davidMadueke/Simple-DAW-Transport-Controller/assets/Endless Encoder Mode Architecture v1.jpg

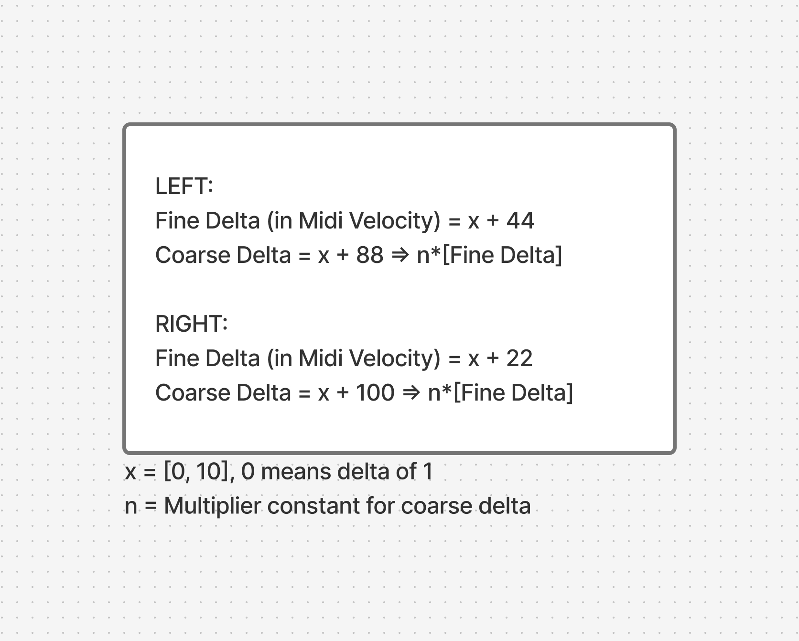
assets/Endless Encoder Mode Architecture v1.jpg
