davidMadueke/Simple-DAW-Transport-Controller/assets/Midi Protocol Architecture v1 13082026.jpg

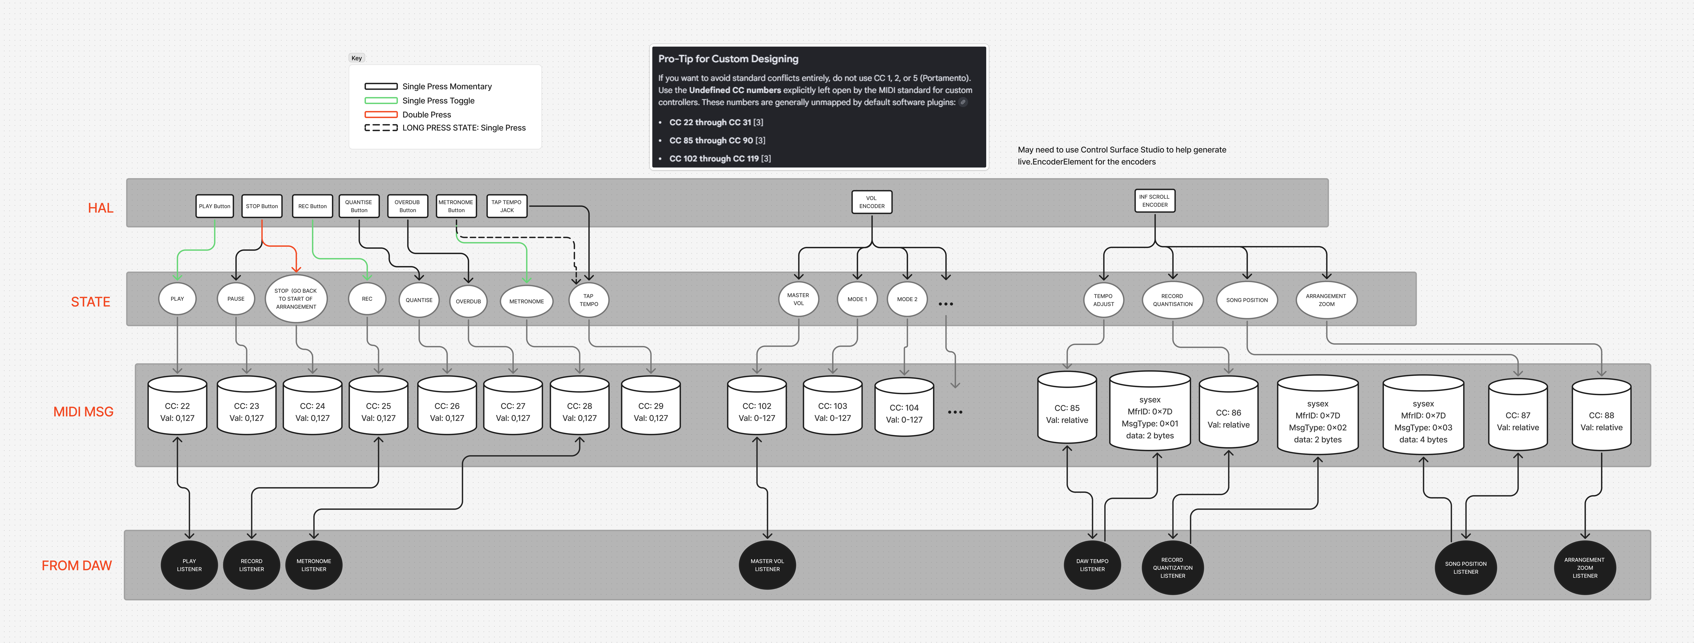
assets/Midi Protocol Architecture v1 13082026.jpg
