davidMadueke/Simple-DAW-Transport-Controller/assets/Midi Sysex Protocol Architecture v1.jpg

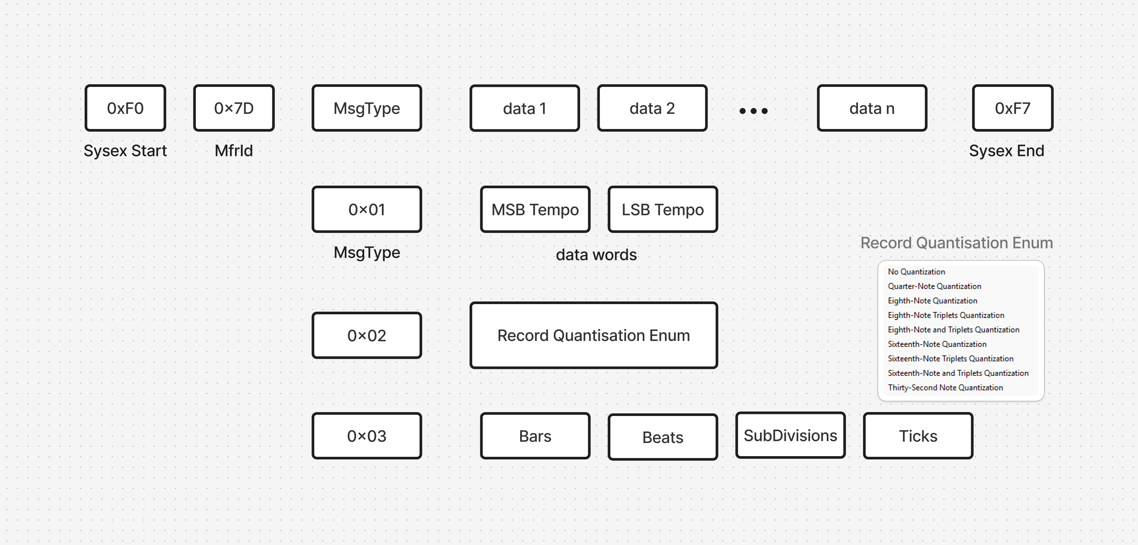
assets/Midi Sysex Protocol Architecture v1.jpg
