davidMadueke/Simple-DAW-Transport-Controller/assets/SW Architecture v7 13082026.png

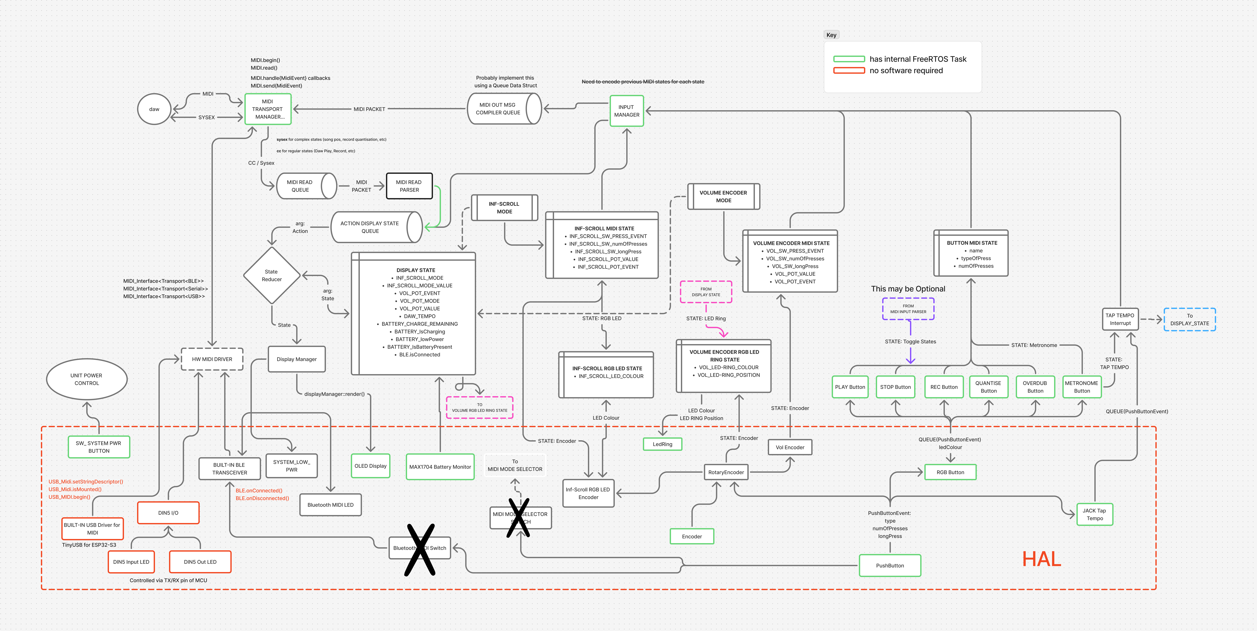
assets/SW Architecture v7 13082026.png
