davidMadueke/Simple-DAW-Transport-Controller/hardware/drawings/10032025_01_[HWE] Simple Transport Midi Controller.pdf

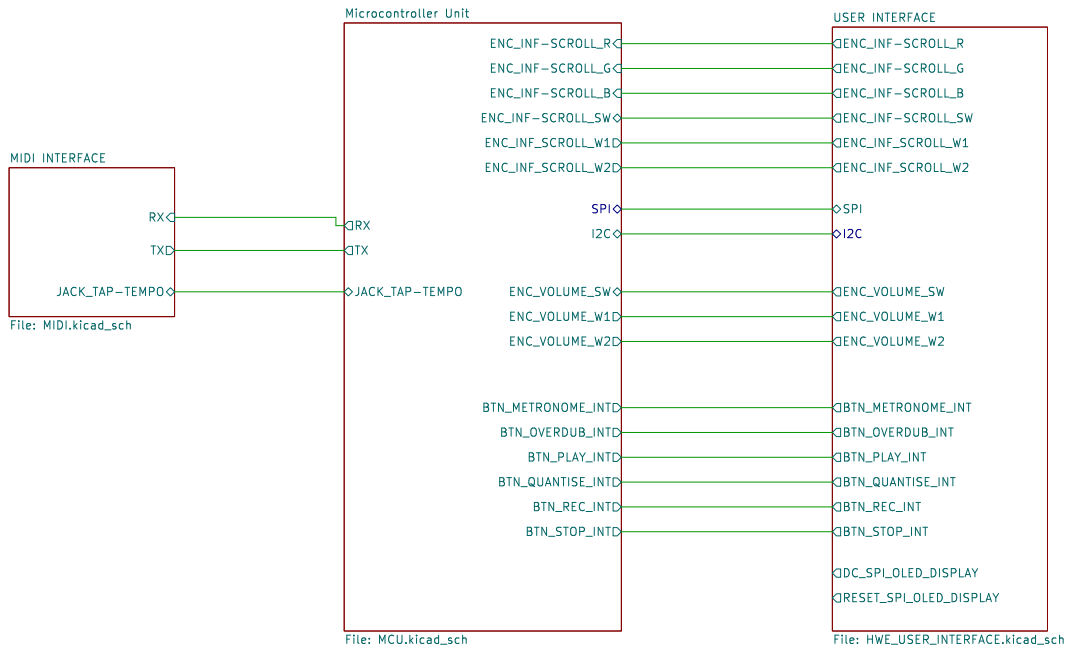
[picture p5: page 1]

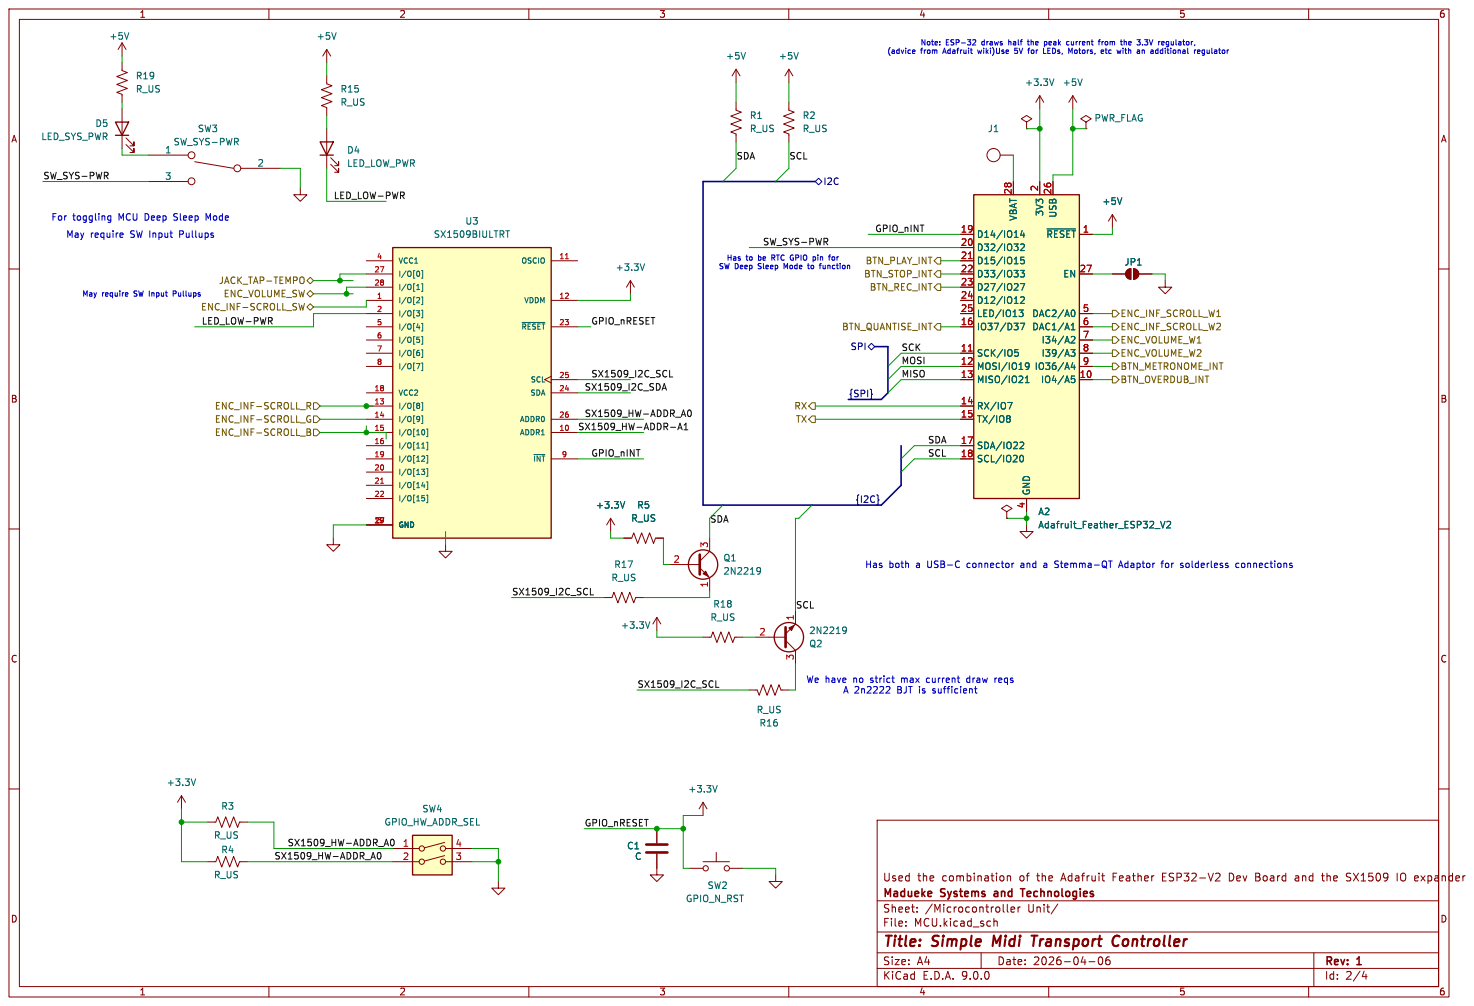
[picture p6: page 2]

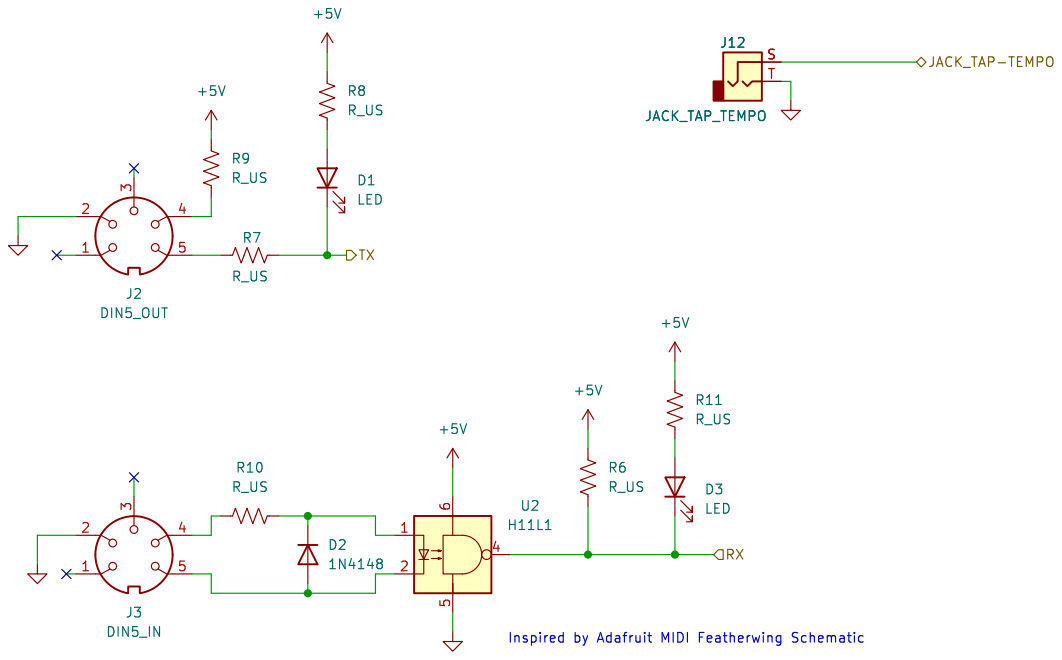
[picture p7: page 3]

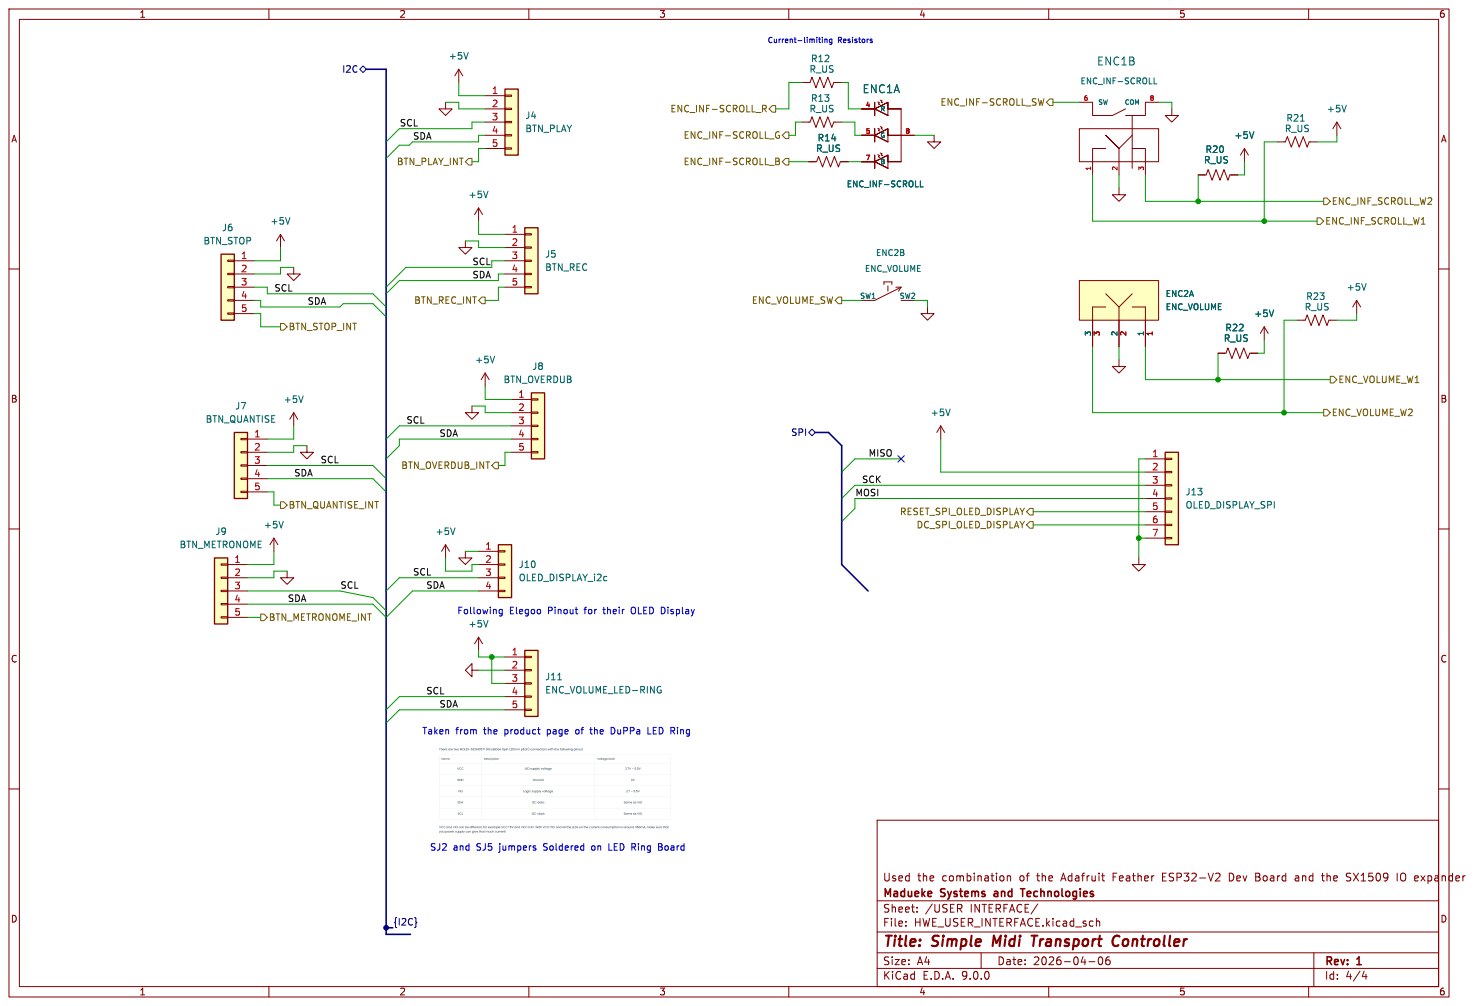
[picture p8: page 4]
