davidMadueke/Simple-DAW-Transport-Controller/hardware/10032025_01_[HWE] Simple Transport Midi Controller.kicad_pcb

## KiCad design hardware/calculator/calculator.kicad_sch

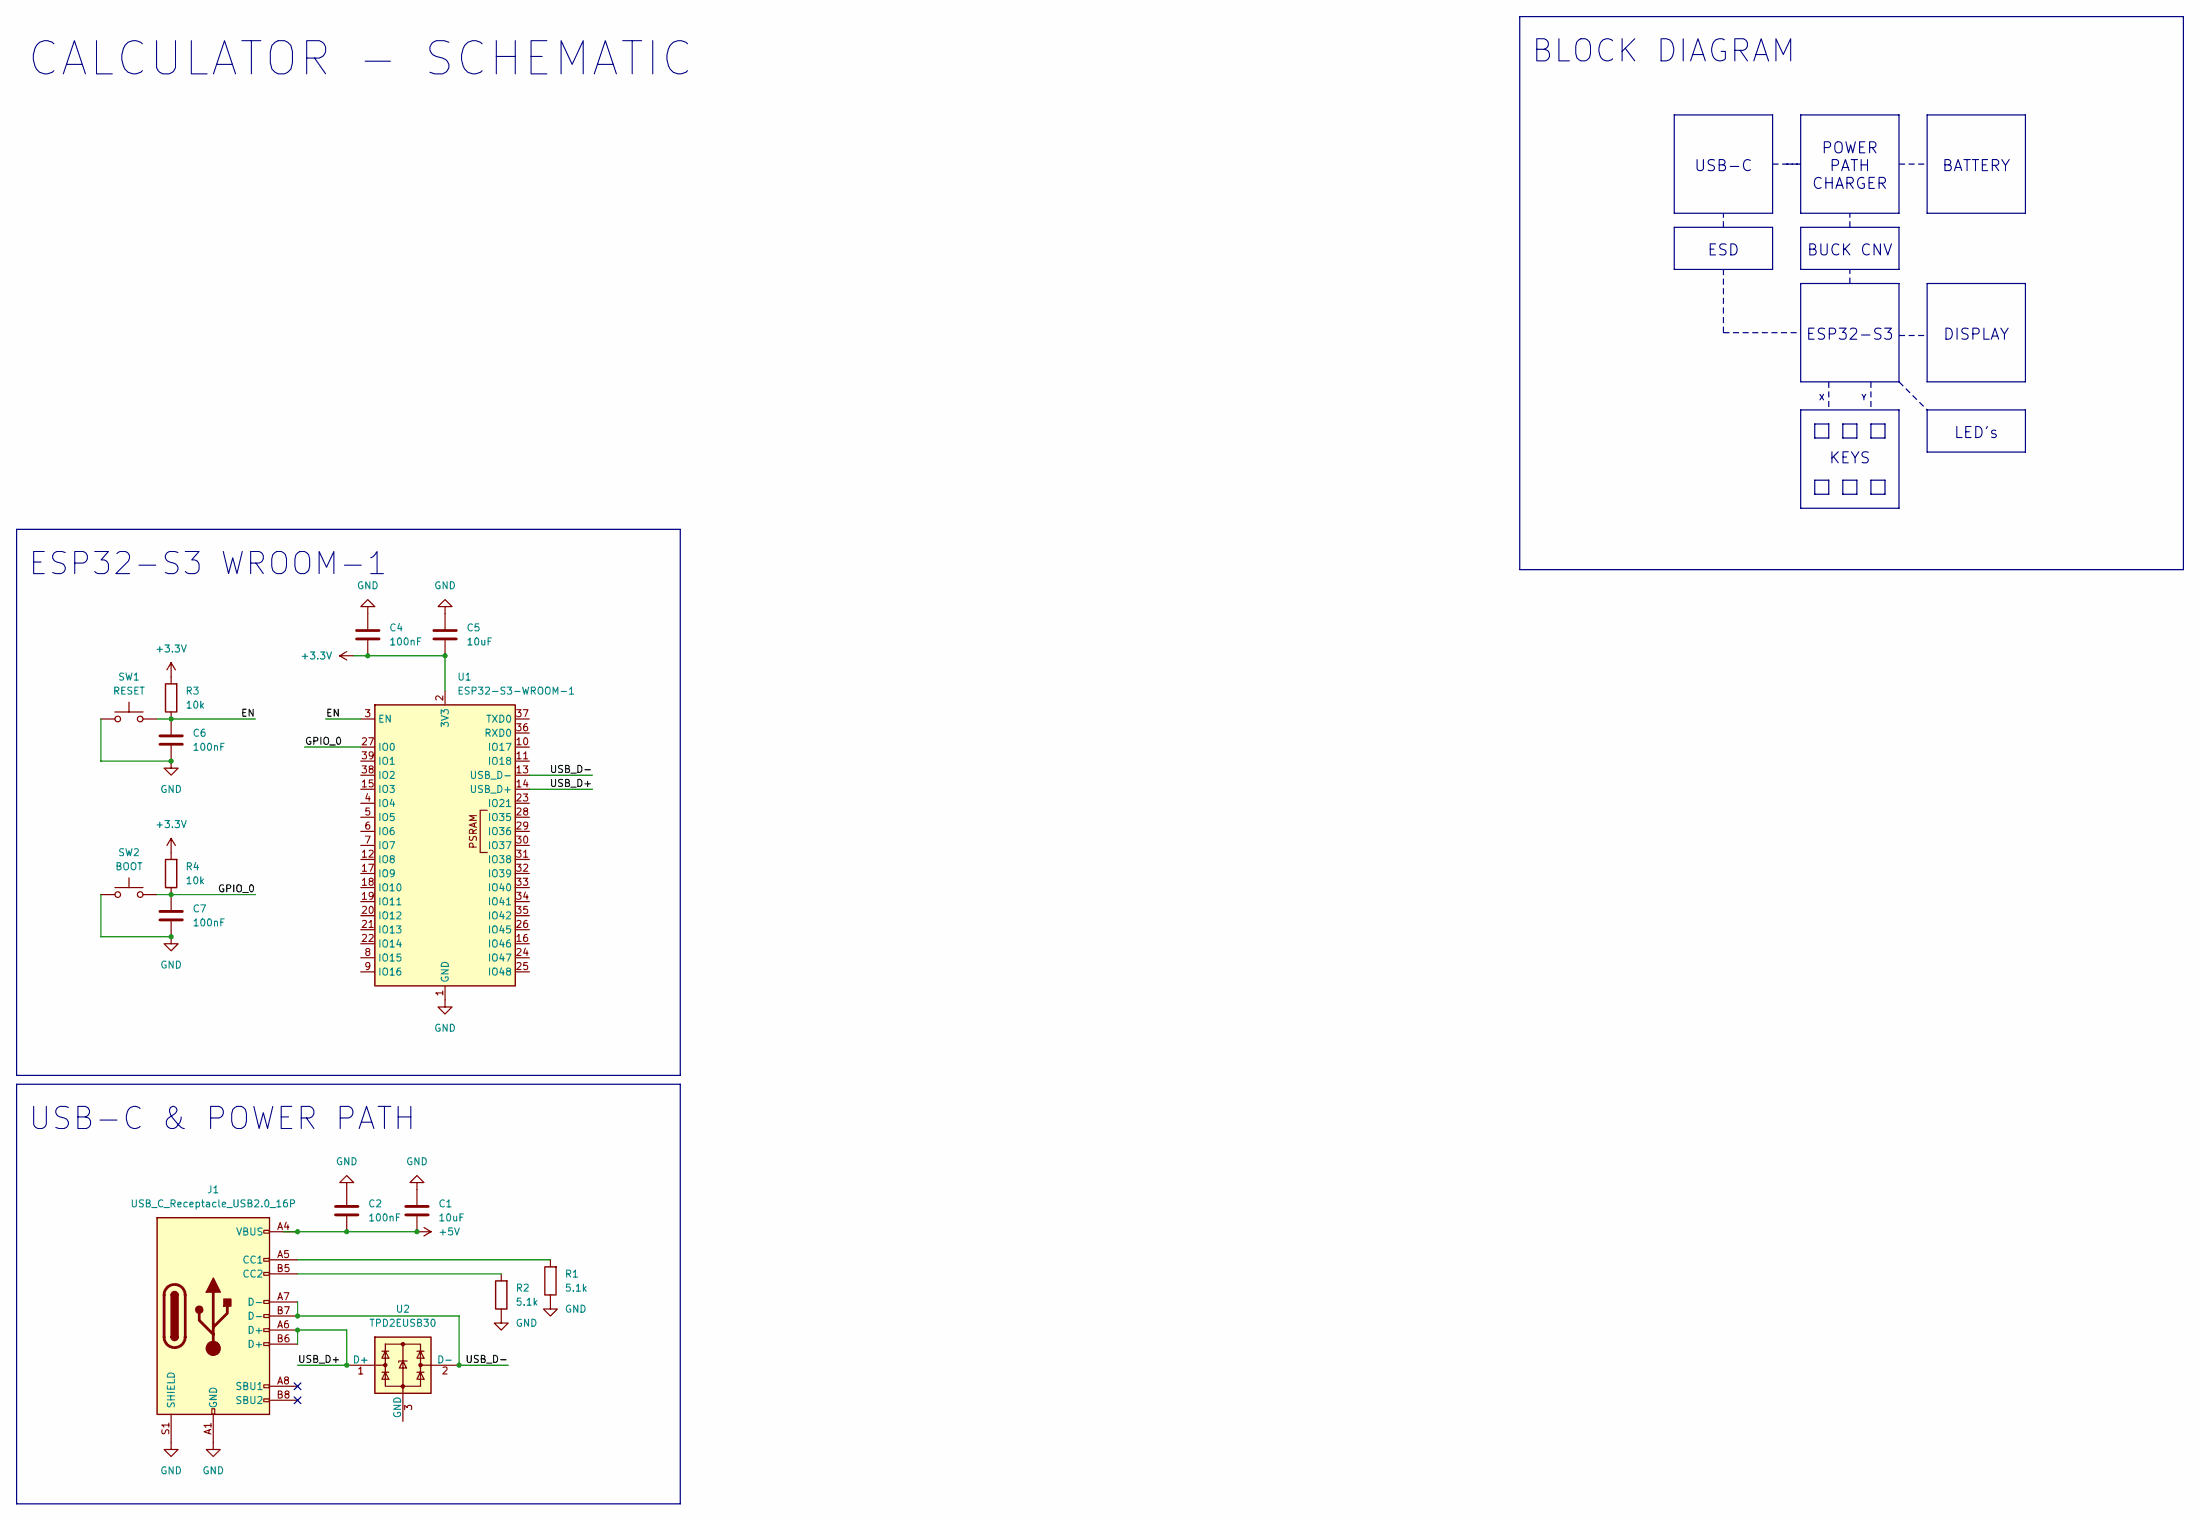
[picture p9: schematic calculator.kicad_sch]

Parts:
C1, C5: 10uF
C2, C4, C6, C7: 100nF
J1: USB_C_Receptacle_USB2.0_16P
R1, R2: 5.1k
R3, R4: 10k
SW1: RESET
SW2: BOOT
U1: ESP32-S3-WROOM-1
U2: TPD2EUSB30; Texas_DRT-3

Connections:
+3.3V: C4.1, C5.1, R3.2, R4.2, U1.2 (3V3)
+5V: C1.2, C2.2, J1.A4 (VBUS), J1.A9 (VBUS), J1.B4 (VBUS), J1.B9 (VBUS)
EN: C6.2, R3.1, SW1.2, U1.3 (EN)
GND: C1.1, C2.1, C4.2, C5.2, C6.1, C7.1, J1.A1 (GND), J1.A12 (GND), J1.B1 (GND), J1.B12 (GND), J1.S1 (SHIELD), R1.1, R2.1, SW1.1, SW2.1, U1.1 (GND), U1.40 (GND), U1.41 (GND)
GPIO_0: C7.2, R4.1, SW2.2, U1.27 (IO0)
unnamed: J1.A5 (CC1), R1.2
unnamed: J1.B5 (CC2), R2.2
USB_D+: J1.A6 (D+), J1.B6 (D+), U1.14 (USB_D+), U2.1 (D+)
USB_D-: J1.A7 (D-), J1.B7 (D-), U1.13 (USB_D-), U2.2 (D-)

Notes on the sheet:
USB-C
BLOCK DIAGRAM
ESD
LED's
ESP32-S3
USB-C & POWER PATH
CALCULATOR - SCHEMATIC
BATTERY
KEYS
POWER PATH CHARGER
DISPLAY
ESP32-S3 WROOM-1
BUCK CNV
