davidMadueke/Simple-DAW-Transport-Controller/(commit log)

2025-04-11 feat [HWE]: Create Kicad Project Files
    [10032025_01_[HWE] Simple Transport Midi Controller.kicad_pcb, 10032025_01_[HWE] Simple Transport Midi Controller.kicad_sch]
2025-04-11 feat [HWE]: added 4ms footprint and sym lib
2025-04-28 feat: created ADAFRUIT_FEATHER_ESP32_V2 Sym and FP
    [10032025_01_[HWE] Simple Transport Midi Controller.kicad_sch, HWE_USER_INTERFACE.kicad_sch, MCU.kicad_sch, MIDI.kicad_sch, PSU.kicad_sch]
2025-04-30 feat: Added MCP23017 SOIC GPIO Expander
    Finished off the design of all of the non-GPIO pins of the expander
    [MCU.kicad_sch]
2025-04-30 feat: Created DIN5 MIDI Interface to Schematic
    [MIDI.kicad_sch]
2025-05-03 feat: Created Button I2C Interfaces
    For now, all we are using is generic 1x5 Connectors following the DFR Robot's RGB Button pinout https://wiki.dfrobot.com/SKU_DFR0991_Gravity_I2C_RGB_LED_Button_Module#target_9
    [10032025_01_[HWE] Simple Transport Midi Controller.kicad_sch, HWE_USER_INTERFACE.kicad_sch, MCU.kicad_sch, MIDI.kicad_sch]
2025-05-08 feat: Added Volume and Inf Scroll Encoders
    [10032025_01_[HWE] Simple Transport Midi Controller.kicad_sch, HWE_USER_INTERFACE.kicad_sch, MCU.kicad_sch]
2025-05-08 feat: Added Footswitch Jack Conn for Tap Tempo
    [MCU.kicad_sch, MIDI.kicad_sch]
2025-05-10 feat: Connected main HW UI components to MCU
    [10032025_01_[HWE] Simple Transport Midi Controller.kicad_sch, HWE_USER_INTERFACE.kicad_sch, MCU.kicad_sch]
2025-05-21 feat [SWE]: Created Button HW Abstraction Layer
2025-06-03 feat [SWE]: Created Button HAL
2025-06-30 feat [HWE}; Added SPI Oled and refactor DuPPa LED
    [10032025_01_[HWE] Simple Transport Midi Controller.kicad_sch, HWE_USER_INTERFACE.kicad_sch, MCU.kicad_sch]
2025-06-30 feat [SWE]: Created LED Ring HAL object
2025-06-30 fix [SWE]: Refactor Button HAL object
2025-06-30 feat [SWE]: Implemented LED Ring class
2025-07-05 fix [HWE]: Updated KiCAD with Lib Change
2025-08-21 feat [SWE}: Created SysPwrSwitch HAL Obj
    Also simulated a test circuit to verify that the power switch with a hardware controlled LED works as intended. This can be found in the power-switch-demo WOKWI simulation file
2025-08-21 fix [HWE]: SYS_PWR_SW, BJT as a SX1509 Lvl Shifter
    [HWE_USER_INTERFACE.kicad_sch, MCU.kicad_sch]
2025-08-24 feat [SWE]: Created LED Ring HW Unit Test
2025-08-24 fix [SWE]: added support for PWR_MAN and minor fix
    [constants.h, i2c_addresses.h, pins.h]
2025-08-24 feat [SWE]: Created Power Manager Class
2025-08-24 fix [SWE]: Minor test/ dir fixes
    [test_Button.cpp]
2025-08-24 fix [SWE]: Switched to stable vers of ESP-IDF PIO
    it was inspired by this comment https://github.com/espressif/arduino-esp32/issues/10721#issuecomment-2539567775 given that we were directly using calls to the main ESP-IDF core for Arduino
    "you have mixed versions of this repo. PlatformIO provides up to a very old now version 2.0.17. PlatformIO no longer supports the newer versions of ESP32 Arduino."
2025-08-30 fix [SWE]: Fixed LEDRing_Duppa HAL implementation
2025-08-30 feat [HWE]: Added LED_LOW_PWR & SW_SYS_PWR HW
    [MCU.kicad_sch]
2025-08-30 feat [SWE]: Created the BUTTON_MIDI_STATE struct
2025-08-31 fix [SWE]; Fixed INF_SCROLL_MODE and LedState
2025-08-31 feat [SWE]: Created Rotary Encoder HAL Obj
2025-09-14 fix [HWE]: Added HW Pullups to Rotary Encoders
    [HWE_USER_INTERFACE.kicad_sch]
2025-09-14 fix [HWE]: Reassigned Rot Enc outs to new MCU GPIO
    [HWE_USER_INTERFACE.kicad_sch, MCU.kicad_sch]
2025-09-16 fix [SWE]: Refactored Rot Enc HAL and Vol Enc
    We refactored the codebase to make use of the internal ESP32 Knob class that massively simplifies setting up intterrupts and configuring callbacks for EC11 low Speed Rotary Encoders - which we are using for this project. Note that in Kai Nakamura's Squidbox Project, he makes use of this Class. https://github.com/EAMIRorg/Squidbox/blob/27622cdb37b01c1624662d6617dbf87cf04c72ed/src/components/knob/Knob.cpp
2025-09-16 feat [SWE]: Created Play Button object
2025-09-22 feat [SWE]: Created BUTTON_LED_STATE Struct
2025-09-22 fix [SWE]: BUTTON_LED_STATE Struct
2025-09-22 fix [SWE]: Refactor Play Button Object
    We extracted all members and methods out to MIDI_Button base class and have PlayButton inherit from that. We have done this so that it makes it easier to create the Button Objects for the rest of the RGB Buttons
2025-09-22 fix [SWE]: Refactor MIDI_Button object
    We extract the Toggle ON/OFF Led State, the SinglePress Led inicator State and the LongPress Led States to their own methods that can be called in the child button constructor - allowing us to customise the internal LED State functionality of each child Button
2025-09-22 feat [SWE]: Create remaining MIDI Buttons
2025-09-25 fix [SWE]: Refactor Metbutton for Tap Tempo Func
    We added that once the button goes into long press mode, any subsequent non-long presses will set the TAP_TEMPO_STATE
2025-09-25 feat [SWE}: Added Toggle Switch Obj to PushButton
    inspired by JChristensen's Impl https://github.com/JChristensen/JC_Button implementation of the Button Class, it inherits from my custom PushButton Class
2025-10-03 fix [SWE]: Fixed Button State Machine logic
2025-10-03 feat [SWE} Created BLE Module Button State Machine
2026-03-24 fix [SWE]: Button Class
2026-03-24 misc [swe]: Added i2c_scanner helper
2026-04-06 feat![HWE]: Changed MCU to Adafruit ESP32-S3
    [10032025_01_[HWE] Simple Transport Midi Controller.kicad_sch, HWE_USER_INTERFACE.kicad_sch, MCU.kicad_sch, MIDI.kicad_sch]
2026-04-07 fix [HWE]: Place DNPs for unused Pins
    [MCU.kicad_sch]
2026-04-07 feat [HWE]: Add to SX1509 Circuitry
    We adapt the SX1509 of the design to the design used in the sparkfun SX1509 Breakout Board https://cdn.sparkfun.com/assets/learn_tutorials/4/3/4/sx1509-breakout-schematic.pdf
    [HWE_USER_INTERFACE.kicad_sch, MCU.kicad_sch]
2026-04-18 fix [HWE]: Moved Inf Scroll ARGB pins on SX1509
    Shifted the pins of the R, G and B pins of the infinite scroll encoder from pins 9 - 11 on the SX1509, to pins 8 - 10
    [HWE_USER_INTERFACE.kicad_sch, MCU.kicad_sch]
2026-05-11 feat [SWE]: Refactored HW Config to ESP32-S3
2026-05-11 fix [SWE]: Removed Button Func for BT module
    [test_BluetoothModule.cpp]
2026-05-18 fix [SWE]: Added BLE and SER midi macros
    [pins.h]
2026-05-22 fix [SWE]: Switched UsbMidiModule to Adafruit_USBD_MIDI
    I ended up removing the UsbMidiModule as most of the main logic is already covered with Adafruit_USBD_MIDI object. Also (answer taken from Google Gemini LLM Chat session): When you call MIDI_CREATE_INSTANCE(Adafruit_USBD_MIDI, usb_midi, MIDI); in the global scope, it expects usb_midi to be a permanent, statically allocated global object. If you pass it a temporary pointer or a dynamically retrieved class instance via a->getUsbMidi(), the Arduino MIDI Library creates an internal duplicate that is disconnected from the TinyUSB core stack, breaking the descriptor strings and the USB connection.
2026-05-22 fix [SWE]: Changed Rot Encoder Backend to mathertel
    Changed from using the ESP-KNOB arduino lib to the mathertel/RotaryEncoder Library
    [pins.h]
2026-05-23 misc [SWE]: Renamed custom Rotary Encoder Class
2026-05-29 fix [SWE]: Implemented PushButton class with FreeRTOS support for debouncing and multi-press detection
    [test_PushButton_BLE_Switch.cpp]
2026-05-29 misc [SWE]: Fixes to earlier commit
    [test_RotaryEncoder.cpp]
2026-05-29 misc [HWE]: Clarified SYS_PWR functionality
    [HWE_USER_INTERFACE.kicad_sch, MCU.kicad_sch]
2026-05-29 fix [SWE]: Refactor SYS POWER Switch and PWR MGR
    [constants.h]
2026-05-31 fix: Adafruit ESP32s3 Feather Pin Names
2026-05-31 fix [SWE]: Refactor RGB button Object for FreeRTOS
    [constants.h, pins.h, test_Button.cpp]
2026-06-07 feat [SWE]: Refactored MIDI_Button to FreeRTOS task
    As a test, I refactored both Metronome Button and Jack Tap Tempo such that the metronome button works in Metronome mode, but on a long press switches to Tap Tempo mode, and then emits single press events to the Jack Tap Tempo event Queue
2026-06-07 fix [SWE]: Refactor test_button.cpp
    [test_Button.cpp]
2026-06-08 misc [swe]: Switch when digitalLedWrite is called
2026-06-11 misc [HWE]: Clarified Pin Status of SPI OLED display
    [HWE_USER_INTERFACE.kicad_sch]
2026-06-12 fix [HWE]: Update SPI OLED RES and DC connections
    The RES pin of the OLED display is now connected to the RESET pin of the MCU, the DC pin will be routed to the GPIO pin D13 (at the cost of continually driving the BUILITIN LED)
    [HWE_USER_INTERFACE.kicad_sch, MCU.kicad_sch]
2026-06-12 misc [SWE]: Added SPI OLED DISPLAY pin defs
2026-06-12 test [SWE]: Added test for HAL OLED Display driver
2026-06-12 feat [HWE]: Added probe points to SPI connections
    [10032025_01_[HWE] Simple Transport Midi Controller.kicad_sch, HWE_USER_INTERFACE.kicad_sch, MCU.kicad_sch]
2026-06-12 refactor [SWE]: Update button classes to use PushButtonEvent for state management
    [Used Cursor Composer 2.5 Agent Mode] Refactored RecButton, QuantButton, OverdubButton, StopButton, and PlayButton to utilize PushButtonEvent for handling button states. This change improves the clarity and functionality of the state machines, allowing for better event handling and LED state management.
2026-06-13 fix [HWE]: Fix orientation of SX1509 SDA BJT (as Level Shifter)
    [HWE_USER_INTERFACE.kicad_sch, MCU.kicad_sch]
2026-06-14 misc [SWE]: Attached input queue lengths to macro
2026-07-05 fix [HWE]: Changed INF_SCROLL Enc to Enc + RGB LED
    I have decided to switch from using this RGB LED encoder for the infinite scroll encoder to using a regular Rotary Encoder ( same as the Volume Encoder) with an associated common cathode RGB LED - it has the same functions, its just that this time it becomes so much easier to deal with in firmware. I was having massive troubles with the RGB encoder above as it was common anode for both switch and LEDs, and the Rotary Encoder itself used a different schema to that of my regular KY-040 rotary Encoders.
    In fact I am even considering just using these KY-040 modules instead of routing out my own PEC11s to my PCB
    [HWE_USER_INTERFACE.kicad_sch]
2026-07-05 misc [SWE]: Added Input Pin Mode arg to PushButton
2026-07-05 fix [SWE]: Refactor INF-SCROLL Enc for FREERTOS
    We integrated in the test.cpp file the integration with the SX1509 Io EXPANDER MAKING USE OF THE io.analogWrite functionality. We also created a FREERTOS queue set to concatenate both Encoder and Pushbutton events into one "Queue". To accomplish this, we migrated the task notification schema from the Encoder ISR from a notification to a binary semaphore
    [constants.h, test_InfScroll_Encoder.cpp]
2026-07-05 feat [SWE]: Created rSerial RTOS safe Serial Obj
    This object is simply just a task that adds serial messages to a queue if the RSerial object is defined, if it isnt, it just defaults to the regualr serial.print function
2026-07-05 fix [SWE]: Refactor Volume Encoder for FREE RTOS
2026-07-05 misc [hwe]: Fixed INF_SCROLL ENC RGB LED
    It was the incorrect configuration. The ones I have have the pin out of Pin 1 = Red, 2 = Common Cathode, 3 = Green, 4 = Blue
    [HWE_USER_INTERFACE.kicad_sch]
2026-07-06 ai-feat [SWE]: Enhance LedRing functionality and FreeRTOS integration
    [Used Opus 4.8 Agent Mode]
    - Added new build flags for LED quantization and test selection in platformio.ini.
    - Refactored delay function to use FreeRTOS task delay in LedRing_DUPPA.cpp.
    - Introduced methods for managing LED color states and FreeRTOS task handling in LedRing.
    - Removed obsolete LedRing pulse test file.
2026-07-06 misc [swe]: Change LED_RING_DUPPA for FREE RTOS
    Forgot to add these changes to the last commit
2026-07-12 feat [HWE]: Attached LED_RING VCC to FET SWITCH
    Attached the LED_RING VCC and VIO pins to a FET switch which is driven by the MCU's RESET pin as I was noticing during prototyping a bug that whenever I went into bootloader mode on the ESP32-S3, the system will not send any i2c LED turn off signals to the LED Ring
    [10032025_01_[HWE] Simple Transport Midi Controller.kicad_sch, HWE_USER_INTERFACE.kicad_sch]
2026-07-17 refactor [SWE]: Used Macros to abstract Encoder States
    Used X Macros to create encoder MODE Tables that have the mode names, LED states and MIDI CC numbers, these mode tables are then used in the ..._MIDI_STATE Enums and the switch statements of their respective LedStateMachines
2026-07-17 fix [SWE]: Fixed LedRing_DUPPA HAL driver
    I also had to create a fork of the underlying DUPPA LedRing_Small library so that I can use the auto incrementing address functionality of the underlying LED Driver to perform buffer writes to the LED ring in one i2c Transaction
    [LedRing_pulse.cpp, LedRing_rtos.cpp, i2c_addresses.h]
2026-08-14 misc [swe] : Moved Button.h into lib/Buttons dir
2026-09-10 feat [SWE]: Create Endless Encoder Test
